codedchip/AMSGateArray/40007/BOM.csv

ID | Name | Designator | Footprint | Quantity | Manufacturer Part | Manufacturer | Supplier | Supplier Part | Price
1 | 2.2uF | C1,C2 | C0805 | 2 | 0805F225M500NT | FH | LCSC | C49217 | 0.018
2 | 220nF | C3 | C0805 | 1 | C0805C224K5RACAUTO | KEMET | LCSC | C129652 | 0.039
3 | XC95288XL-10TQG144I | U2 | LQFP-144_L20.0-W20.0-P0.50-LS22.0-BL | 1 | XILINX | XC95288XL-10TQG144I | LCSC | C13389 | 6.748
4 | MCP1702T-3602ECB | U1 | SOT346 | 1
5 | A2005WR-7P | TP1 | HDR-TH_7P-P2.54-V-F | 1 | A2005WR-7P | Changjiang Connectors | LCSC | C225274 | 0.154
