codedchip/AMSGateArray/(threads)

Thread 2 (2022-06-08):

Prgramming issue

RetroTinkering, 2022-06-08:
Sorry wish I couuld ask this elsewhere  but cannot find another way to contact you.

I have made uup a few of these boards but am stumped on how  to program the .jed files, do the boards need to  be programmed  in place on a CPC board to power the 95288, what software and hardware are you using to program them?

Once again apologise but my only experience of programming CPLD is with them on a board where they are programmed  from a Raspberry Pi.

codedchip, 2022-06-10:
My email address is in all the source files. Feel free to send me a mail.

On Wed, Jun 8, 2022 at 8:39 PM RetroTinkering ***@***.***>
wrote:

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

RetroTinkering, 2022-06-11:
Thanks again, problem was two things  the Xilinx drivers  on  Windows 10, which is a bit of a mess to sort ouut and  the jig I made to supply voltage to the amsgatearray was supplying an  incorrect voltage which was way to low, test the  ones I made uup and  they are working, so all good. .. thanks agaimn

Closed 2022-06-11.

Thread 4 (2022-07-21):

Unstable 40007

CapnRon, 2022-07-21:
I have tested the 40007 board with the correct pins file. It is very unstable and has graphical issues. The system works correctly with an original 40007. With the CPLD 40007 it always boots with graphical issues, although sometime I can get a beep from hitting the delete key, or begin typing a few characters before it locks up. Does anyone have any ideas about what may be wrong? Thanks
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

codedchip, 2022-07-22:
It's hard to diagnose the issue from here, but note that I've only extensively tested this on a 6126, I don't have a 464.
Whenever I've had problems in the past, it's always been either a bridged solder joint on the CPLD or a pin not making good contact with the socket or board. However, as I said I've not tested the 40007 extensively so it might just be a bug. I will try to get hold of a 464 to test and develop it further and perhaps you can work with me on it. My email is in the comments of the source code, drop me a line if you're interested. What type/revision of 464 are you using?

CapnRon, 2022-07-22:
I will make build up a second 40007 just to verify my result and let you know the outcome. I am using a Schneider CPC 464. I will include an image of the board here to reference.
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

CapnRon, 2022-07-23:
I have soldered up a new board I made sure not to make any bridges, and used quality 2% silver bearing solder under a Meiji EMZ-5 inspection microscope. I get the same exact result with the second CPLD. I am using the commercial grade CPLD instead of the industrial grade, I didn't see any other differences in the data sheet than operating temperature range. If you think this is an issue let me know and I will try an industrial chip. I also posted on the CPC forum incase anyone might have any ideas. [https://www.cpcwiki.eu/forum/amstrad-cpc-hardware/gate-array-decapped!/msg217953/#msg217953](url) Let me know if you need me to make any o-scope readings, the system locks up so quickly idk if I can capture anything useful but let me know and I will try to get you some data. I look forward to helping figure this out and testing on the CPC464

CapnRon, 2022-07-23:
Do you think this is possibly an issue of needing logic level shifters on the 464 to work well with all the LS series logic chips?

codedchip, 2022-07-23:
Potentially, but it could be a lot of things. This has only been tested on a 6128 as that's all I have access to, so you should consider the 40007 variant experimental at best. Also note that all I did was change the pinout, so it's really a 40010. I know it works on a later 464 which has sockets for the 40007 and 40010, but as to other types I simply don't know.

CapnRon, 2022-07-23:
Thank you for all your help! You have done amazing work and I will try to sort it out and let you know if I figure it out. Thanks again!

Veto94, 2023-04-07:
I read your problem.
You have been able to program the CPLD. I am begginer in CPLD programming. I use the files provided on this page and the Vivado software from Xilink but the software shows errors when I try to generate the file to be transferred to the CPLD. Could you provide me with the file to be transferred to CPLD . Or possibly the steps to create the file to transfer to the chip

Thank you very much

Best regards

Veto94, 2023-04-12:
Thanks a lot for your help.
I downloaded the ISE software and installed it. I'm not used to this software. When  I create a project with the files, it asks me which device to use and I don't know which one to put.
What should I do, after adding the files, to create the . Jed  and how to transfer it with this software to the programmer and the xilinx chip

Best regards

CapnRon, 2023-04-12:
the device is XC95288XL, once you create the jed you will run impact to program the cpld.

also it is important to only include the correct pins file for the 40010 or 40007 depending on which you are trying to build

psyolent, 2023-11-29:
@codedchip i have a working CPC464 here and am building one from the board that bobs bits has published. i have also ordered that NOS 40007 from the folks in somewhere in europe which should be here in a few weeks. if you can help me with debugging this i will build up a board with CPLD and work with you on this bud? let me know, ta.

Thread 5 (2023-04-03):

Programming CPLD

Veto94, 2023-04-03:
Hello,
I am new to cpld programming.

Maybe you could help me.
I use vivado from Xilink.
I created a new project and added all the verilog files provided on this page. When generating the bitstream file, there are errors and the file is not generated.
Could you give me the different steps to generate the biststream file and load it on the cpld

Best regards

CapnRon, 2023-04-08:
Hello,

Vivado is too new for this CPLD. Use Xilinx ISE to create the .JED file and program the CPLD. you will also need a programmer such as a Platform Cable USB II

CapnRon, 2023-04-12:
This should help get you pointed in the right direction.

https://www.youtube.com/watch?v=2cBOucDP5Ho

CapnRon, 2023-04-27:
did this solve your problem?

Veto94, 2023-04-27:
Hello

Thank you to contact me

I think it s good, but I am waiting for the programmer that I have ordered on eBay
I make the Jed File and If I have a problem,  I will contact you

Thank you again, without your help,I would never have made it

Veto94, 2023-05-01:
Good morning

I'm back
I received the programmer. I open the impact software. Then I add the Xilinx device, and choose the .jed file  then I select usb cable setup . And I get an error message

Cse - A reference voltage has not been detected on the ribbon cable interface to the target system ( pin 2 ).  Check that power is applied to the target system and that the ribbon cable is properly seated at both ends.

The led status is red and there no cable detected

Could you help me

Best regards

CapnRon, 2023-05-02:
You need to power the cpld board. It was very easy for me to simply insert the cpld gate array into my CPC and power it up from the CPC itself. You should notice the green light, then program the cpld with the xilinx platform usb II. Otherwise you will need to use another power supply to power the cpld board

Veto94, 2023-05-04:
> Thanh=k you for your respons
>
> I am going to made a  power but which pin is the +5 volt and which pin is the ground
Best regards

>

CapnRon, 2023-05-04:
VCC on this device is ~3.3v. Do not supply 5v to this circuit. The only 5v on this will be supplied through the CPC socket.

Veto94, 2023-05-05:
Good morning
I believe I made it. I have the green lamp on the programmer, the cable is detected.
I was able to read the device ID. The programming seems to be successful and after  I relaunched impact and I managed to do a readbacktofile. Can you tell me if everything seems correct to you?

Thank you very much

CapnRon, 2023-05-09:
You still haven't told me what version of the board you are building and which pins file you used. Other than that, it sounds like you are able to successfully program the CPLD now so.. Maybe?

You're welcome, I'm glad I was able to help. If you are now able to program the CPLD don't forget to close this issue.

Thanks

CapnRon, 2023-05-11:
@Veto94 Any update on this? Is the CPLD programmed? Good luck!
