codedchip/AMSGateArray/40007/Schematic.pdf

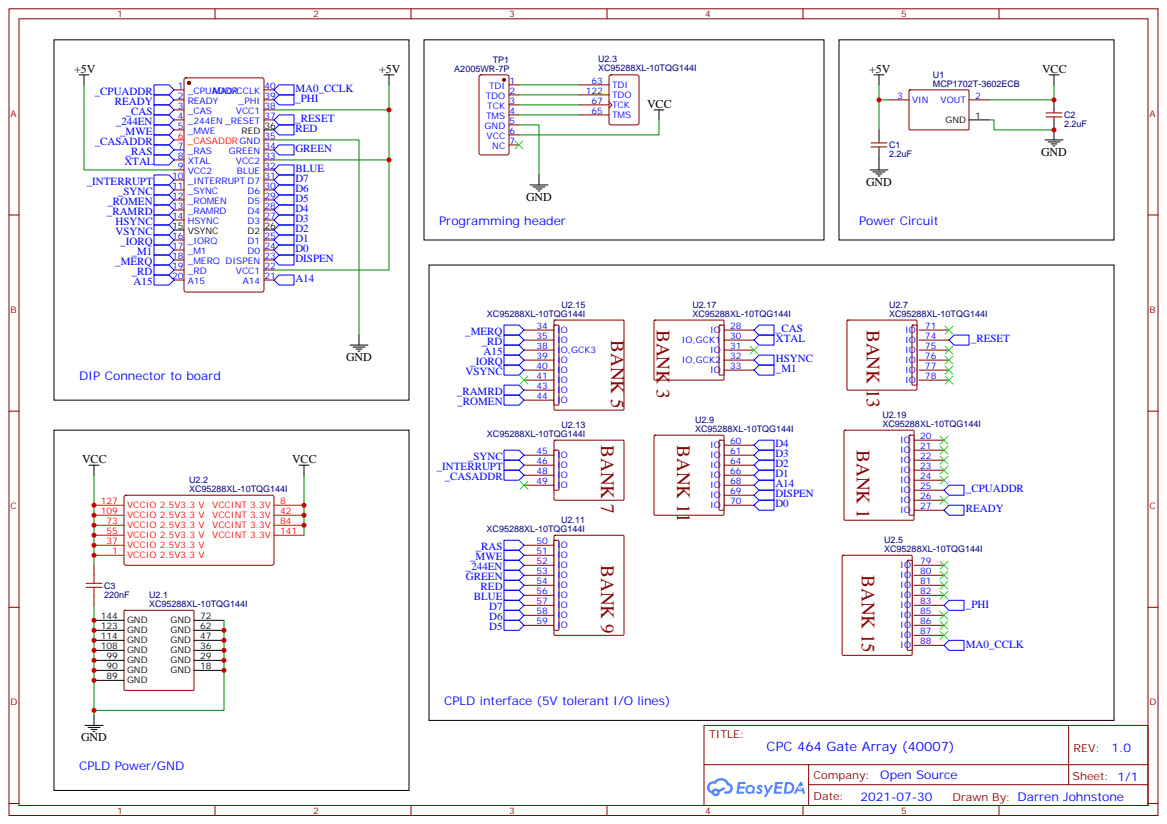
[picture p11: page 1]

DIP Connector to board

VCCIO 2.5V3.3 V 37 VCCIO 2.5V3.3 V 55 VCCIO 2.5V3.3 V 73 VCCIO 2.5V3.3 V 109 VCCIO 2.5V3.3 V 127

XC95288XL-10TQG144I
GND 18 GND 29 GND 36 GND 47 GND 62 GND 72

GND 89 GND 90 GND 99 GND 108 GND 114 GND 123 GND 144

CPLD interface (5V tolerant I/O lines)

Drawn By: Darren Johnstone
