codedchip/AMSGateArray/(commit log)

2022-02-21 Update pins.ucf for AMS40010 v1.6 prototype board
2022-02-21 Adding pin constraints for 40007 gate array.
